sekigon-gonnoc/mtch6102_breakout/MTCH6102_breakout.pdf

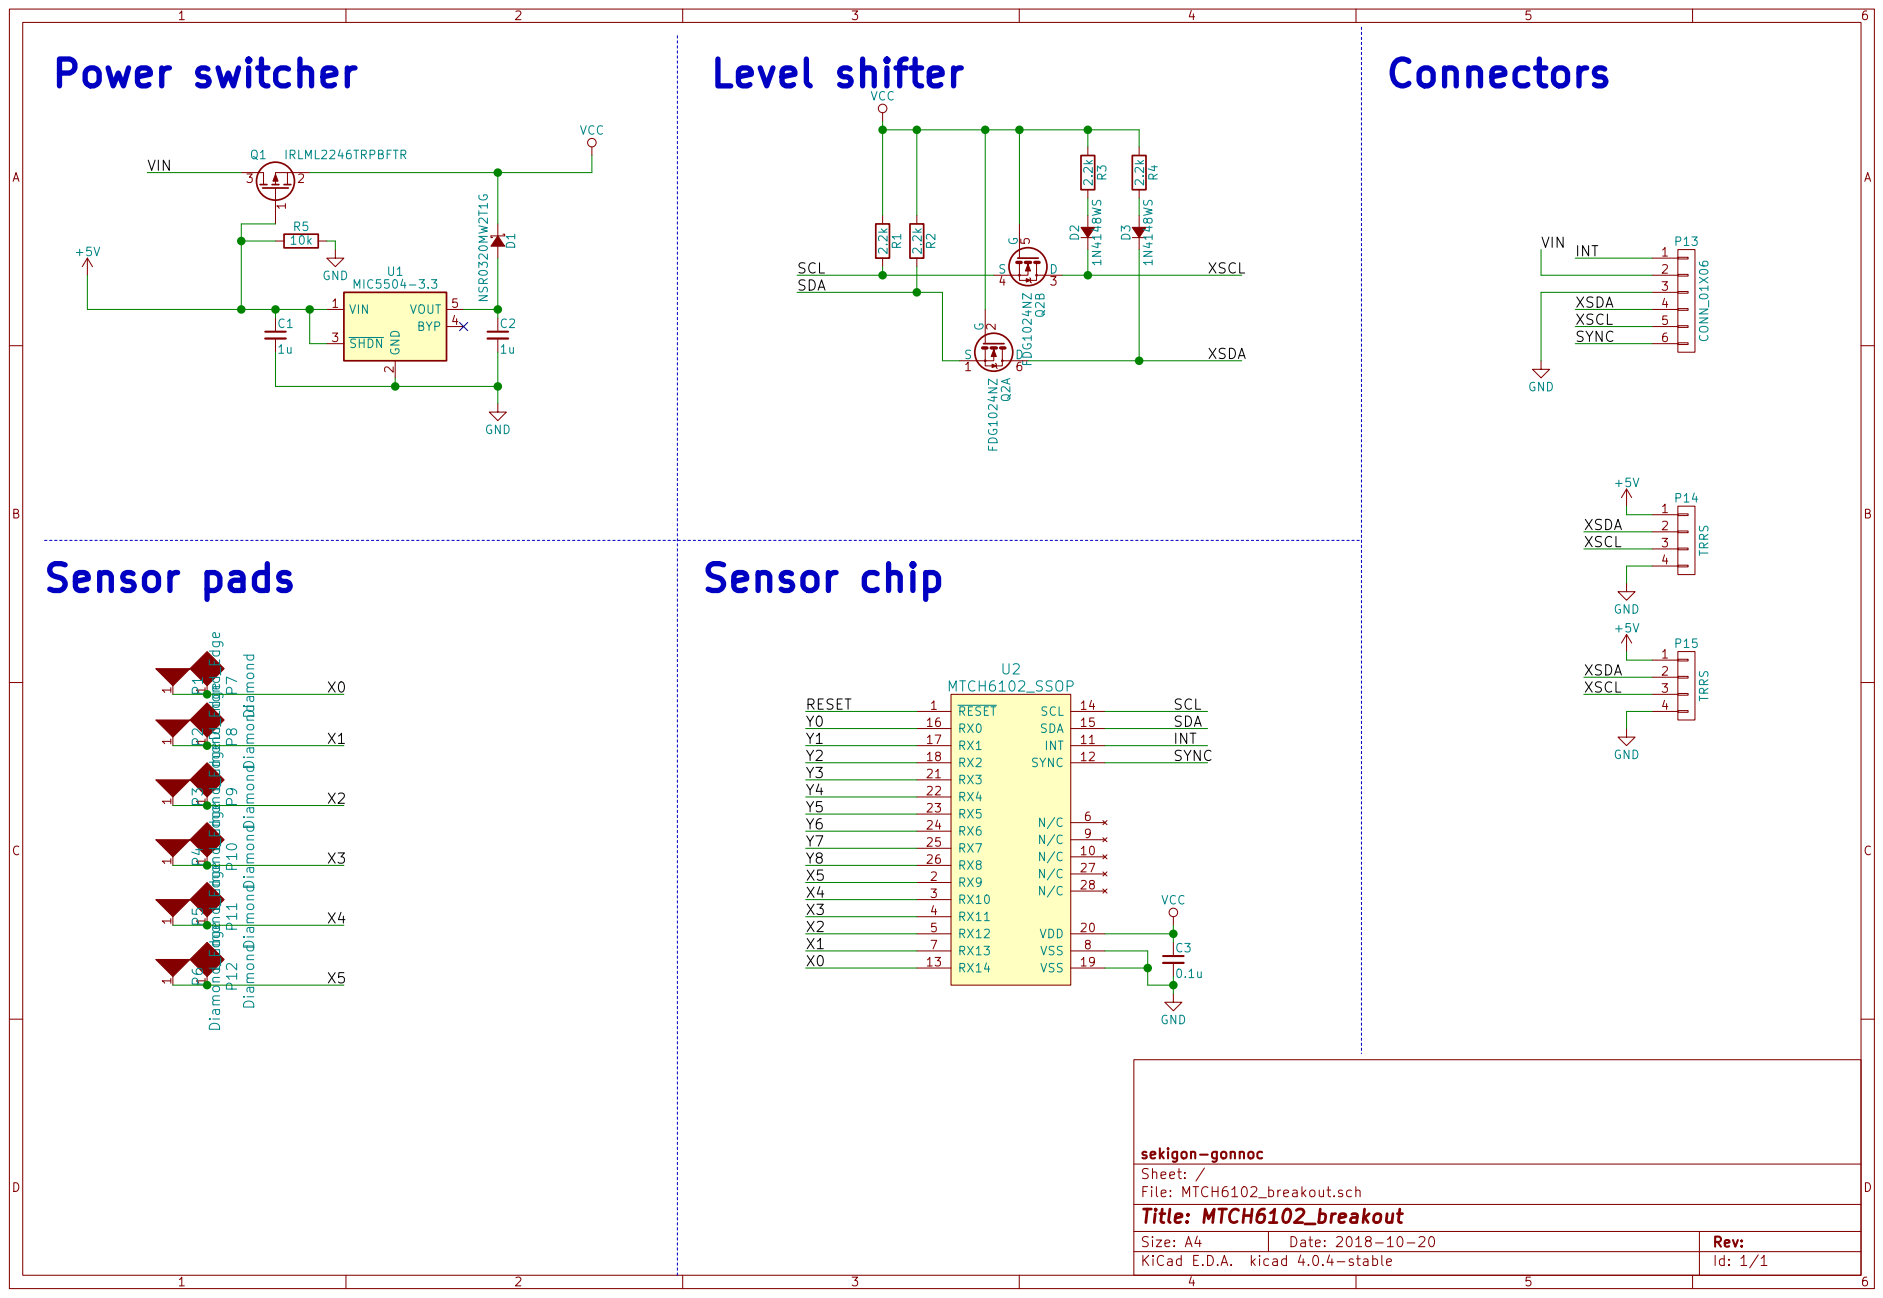
[picture p2: page 1]

File: MTCH6102_breakout.sch Sheet: / sekigon-gonnoc
