sekigon-gonnoc/mtch6102_breakout/MTCH6102_breakout.sch

## KiCad design MTCH6102_breakout.sch (2018-10-20)

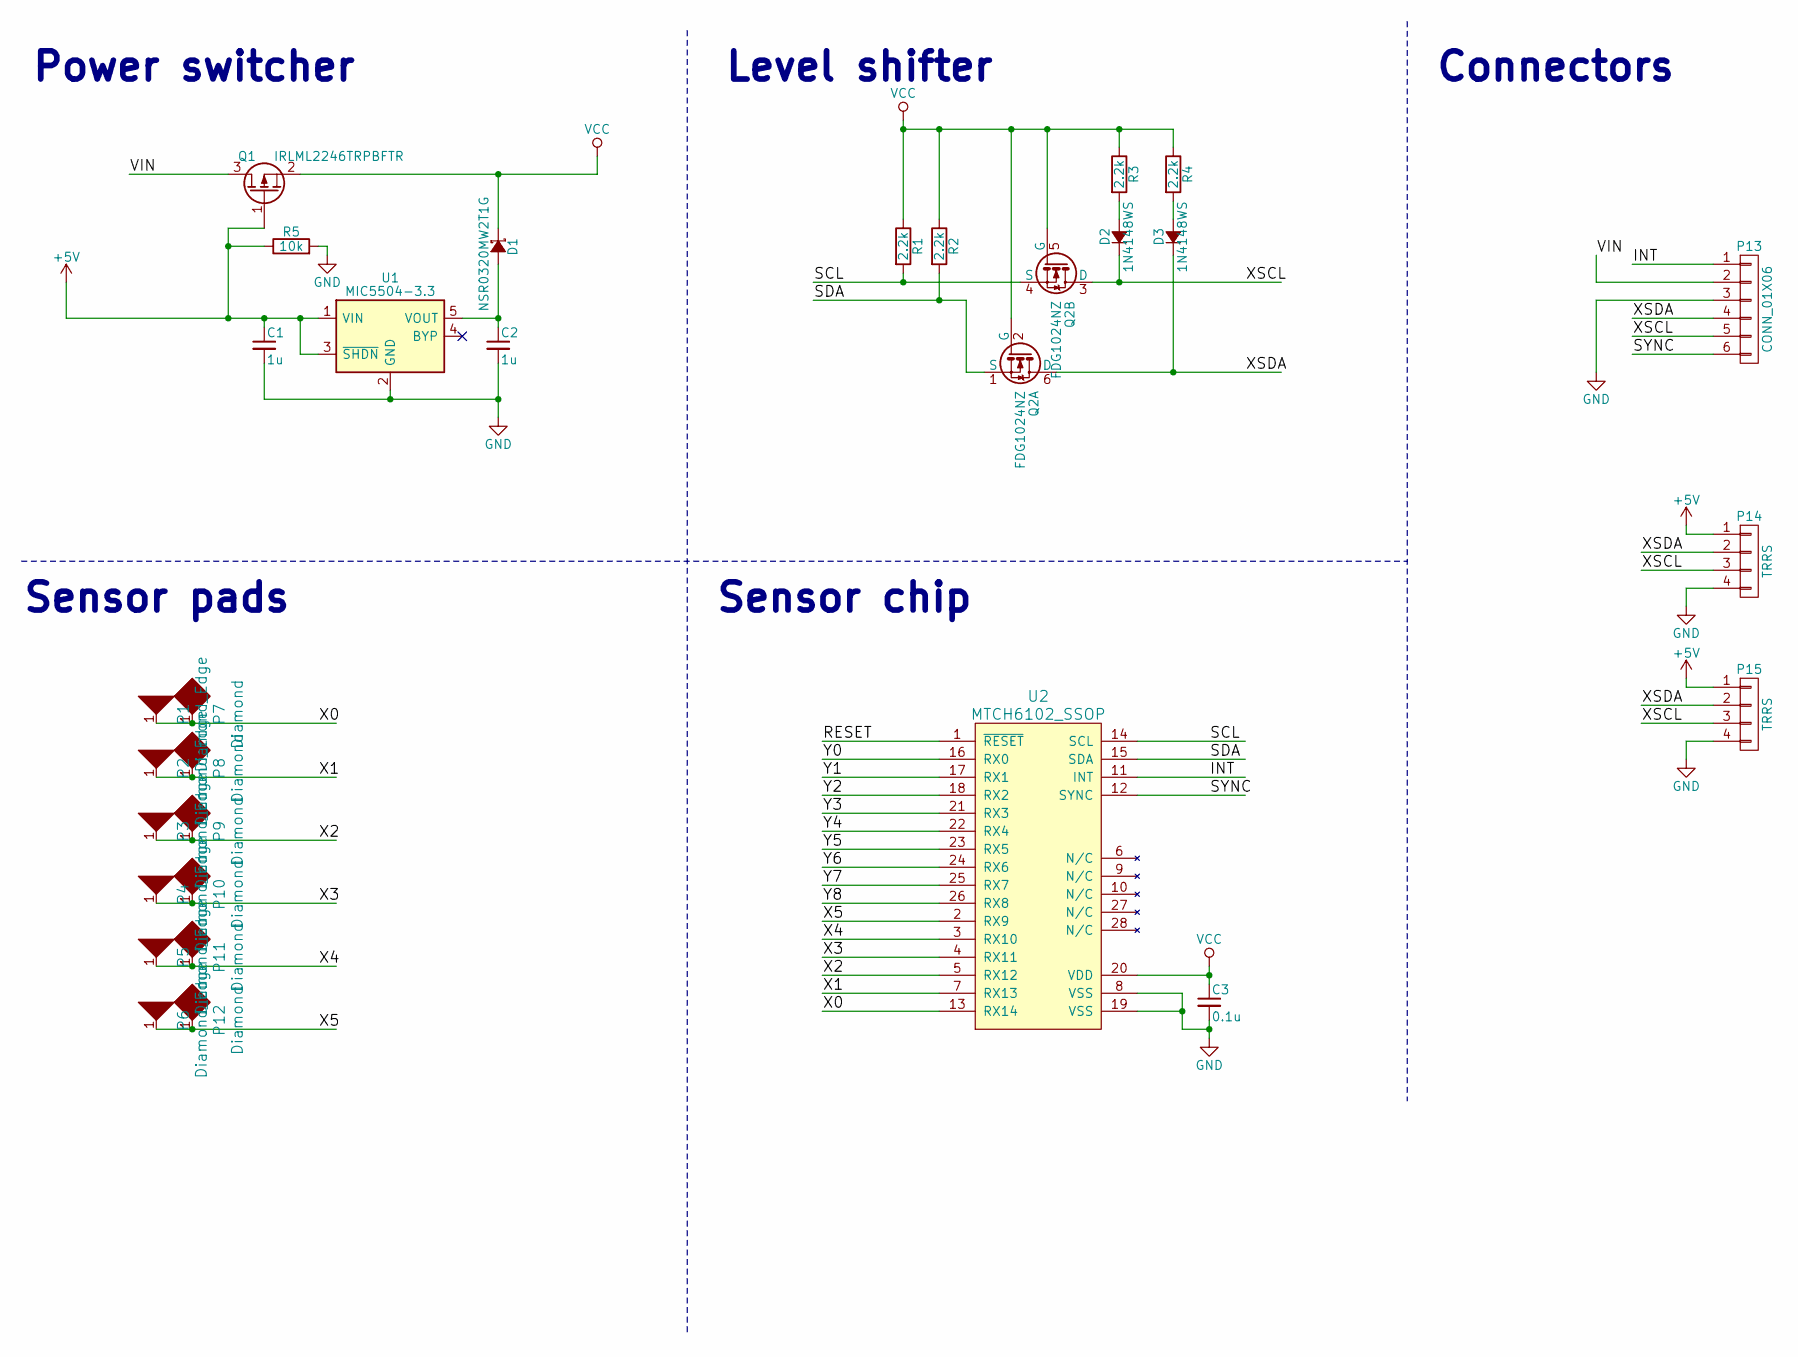
[picture p3: schematic MTCH6102_breakout.sch]

Parts:
C1, C2: 1u; C_0603_HandSoldering
C3: 0.1u; C_0603_HandSoldering
D1: NSR0320MW2T1G; D_SOD-323_HandSoldering
D2, D3: 1N4148WS; D_SOD-323_HandSoldering
P1, P2, P3, P4, P5, P6: Diamond_Edge; diamond_top_edge
P7, P8, P9, P10, P11, P12: Diamond; diamond_top_5mm
P13: CONN_01X06; Pin_Header_Straight_2x03_Pitch2.54mm
P14, P15: TRRS; trrs_jack
Q1: IRLML2246TRPBFTR; SOT-23_Handsoldering
Q2: FDG1024NZ
R1, R2, R3, R4: 2.2k; R_0603_HandSoldering
R5: 10k; R_0603_HandSoldering
U1: MIC5504-3.3; SOT-23-5_HandSoldering
U2: MTCH6102_SSOP; SSOP-28_5.3x10.2mm_Pitch0.65mm

Connections:
+5V: C1.1, P14.1, P15.1, Q1.1 (G), R5.1, U1.1 (VIN), U1.3 (~SHDN)
GND: C1.2, C2.2, C3.2, P13.3, P14.4, P15.4, R5.2, U1.2 (GND), U2.8 (VSS), U2.19 (VSS)
INT: P13.1, U2.11 (INT)
unnamed: C2.1, D1.2 (A), U1.5 (VOUT)
unnamed: D2.2 (A), R3.2
unnamed: D3.2 (A), R4.2
RESET: U2.1 (~RESET)
SCL: Q2.4 (S), R1.2, U2.14 (SCL)
SDA: Q2.1 (S), R2.2, U2.15 (SDA)
SYNC: P13.6, U2.12 (SYNC)
VCC: C3.1, D1.1 (K), Q1.2 (S), Q2.2 (G), Q2.5 (G), R1.1, R2.1, R3.1, R4.1, U2.20 (VDD)
VIN: P13.2, Q1.3 (D)
X0: P1.1, P7.1, U2.13 (RX14)
X1: P2.1, P8.1, U2.7 (RX13)
X2: P3.1, P9.1, U2.5 (RX12)
X3: P4.1, P10.1, U2.4 (RX11)
X4: P5.1, P11.1, U2.3 (RX10)
X5: P6.1, P12.1, U2.2 (RX9)
XSCL: D2.1 (K), P13.5, P14.3, P15.3, Q2.3 (D)
XSDA: D3.1 (K), P13.4, P14.2, P15.2, Q2.6 (D)
Y0: U2.16 (RX0)
Y1: U2.17 (RX1)
Y2: U2.18 (RX2)
Y3: U2.21 (RX3)
Y4: U2.22 (RX4)
Y5: U2.23 (RX5)
Y6: U2.24 (RX6)
Y7: U2.25 (RX7)
Y8: U2.26 (RX8)

Notes on the sheet:
Level shifter
Power switcher
Connectors
Sensor pads
Sensor chip
